ElektorLabs/MultiRF-Dev-Board/hardware/MultiRF_DevBoard/MultiRF_DevBoard.kicad_pcb

## KiCad design hardware/MultiRF_DevBoard/MultiRF_DevBoard.kicad_pcb (2026-07-22)

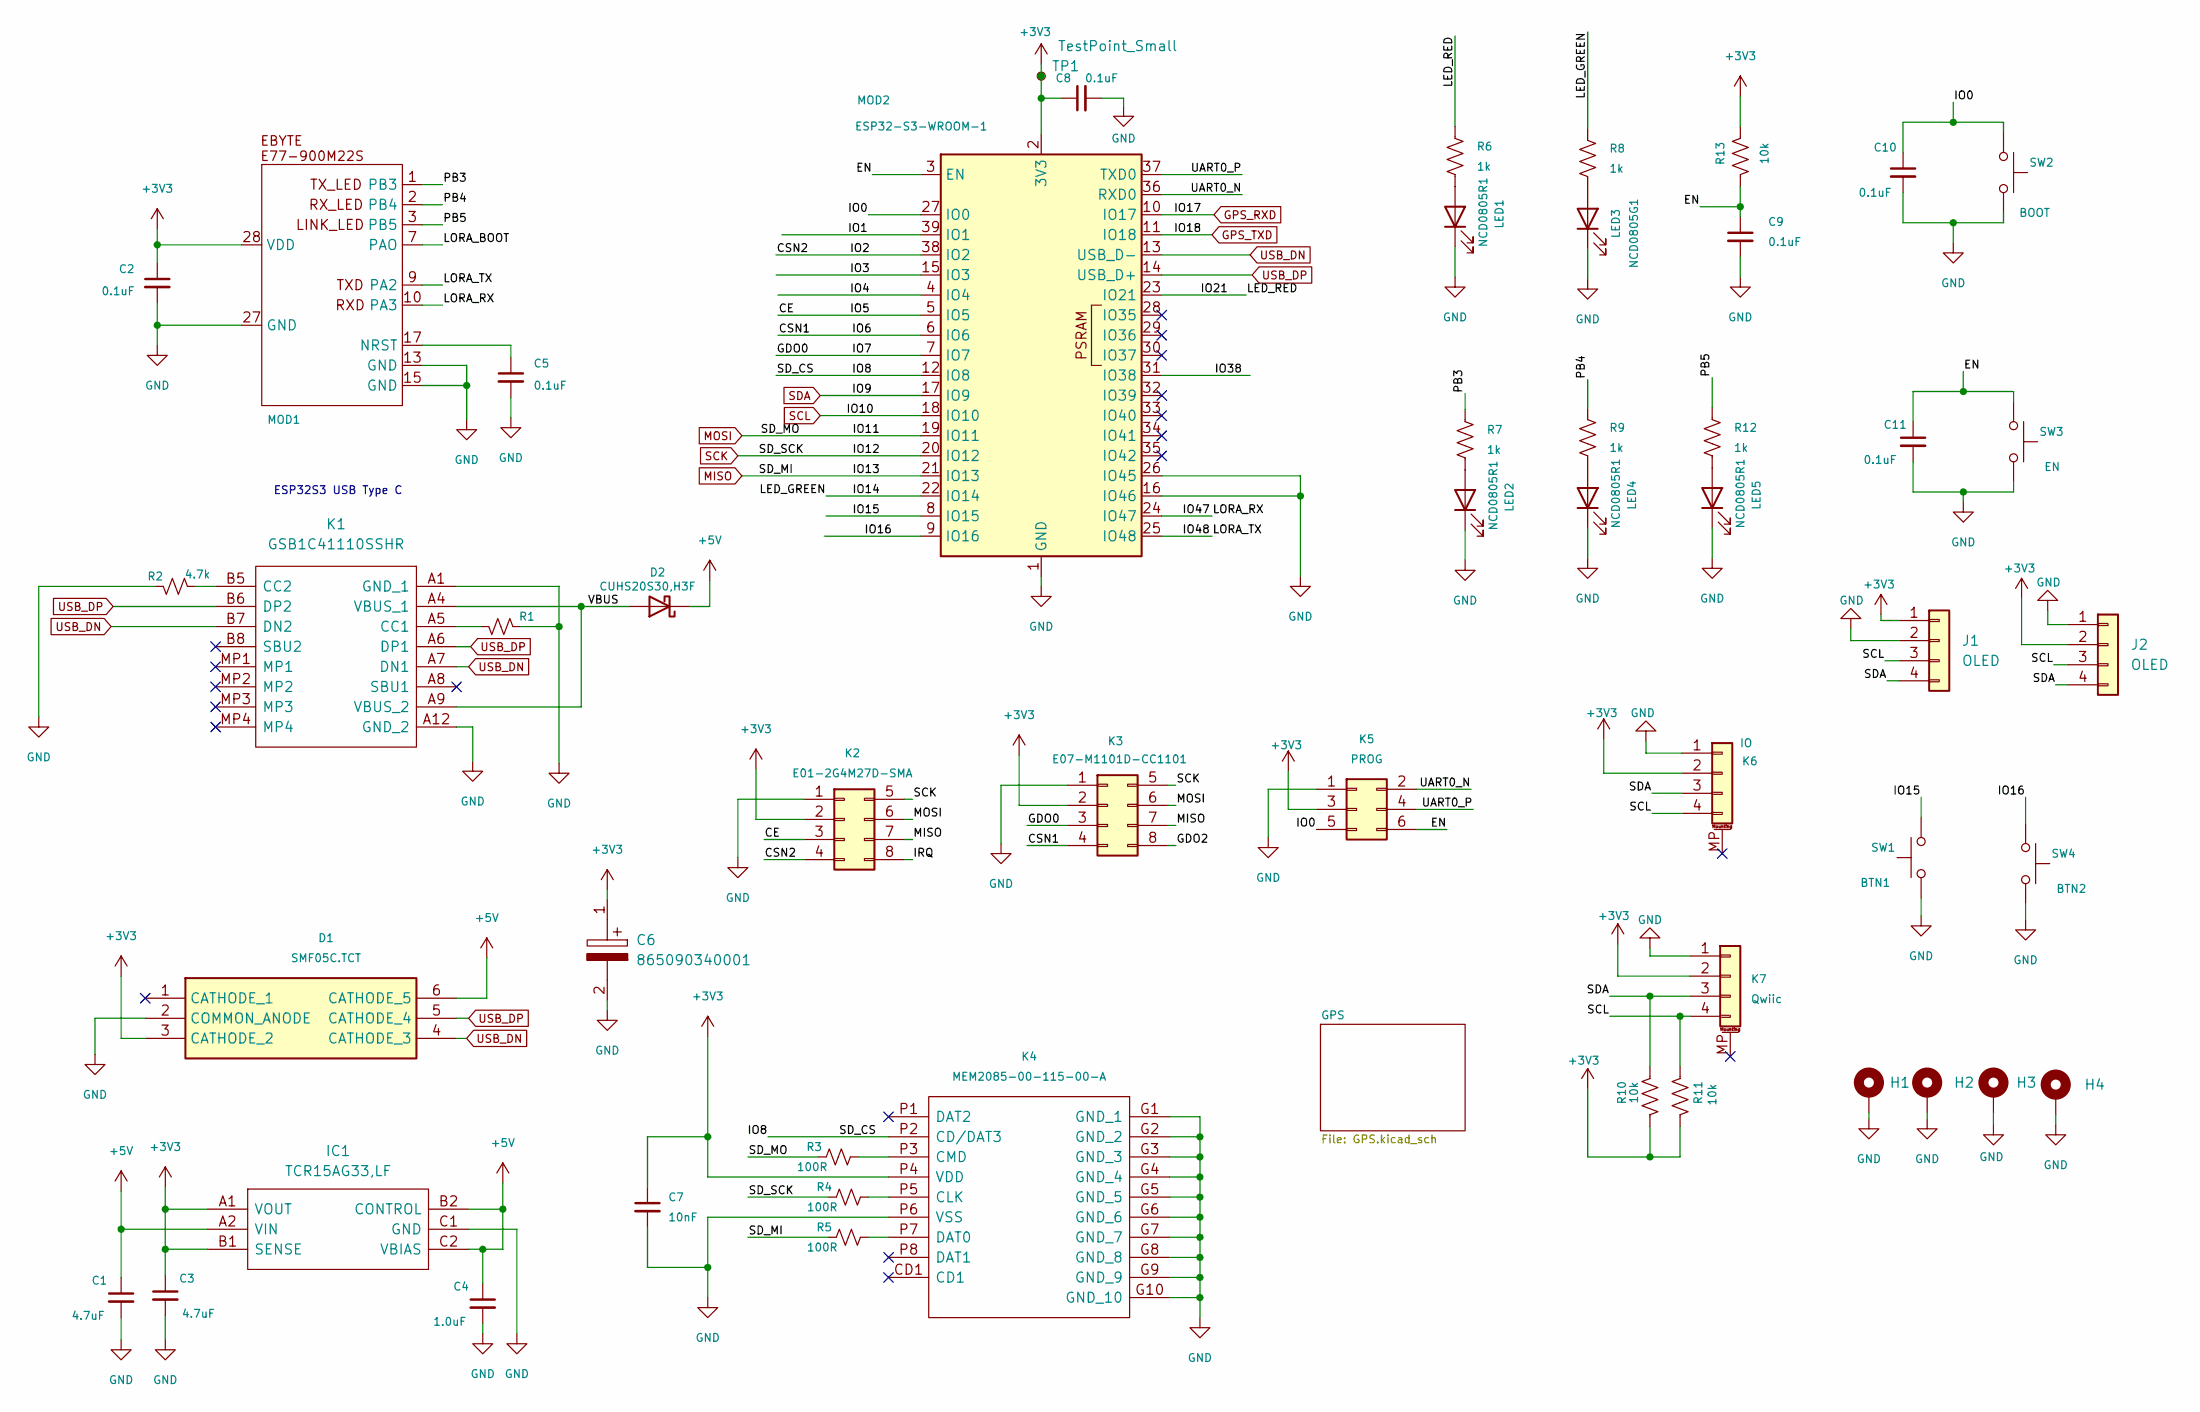
[picture p1: schematic MultiRF_DevBoard.kicad_sch, Wireless Array]

Parts:
C1, C3: 4.7uF; C_0805_2012Metric; Manufacturer_Part_Number C0805C104M5RACTU; Mouser Part Number 80-C0805C104M5R
C2, C5, C10, C11: 0.1uF; C_0805_2012Metric; Manufacturer_Part_Number C0805C104M5RACTU; Mouser Part Number 80-C0805C104M5R
C4: 1.0uF; C_0805_2012Metric; Manufacturer_Part_Number C0805C104M5RACTU; Mouser Part Number 80-C0805C104M5R
C6: 865090340001; CAPAE430X550N; Mouser Part Number 710-865090340001
C7: 10nF; C_0805_2012Metric; Manufacturer_Part_Number C0402C103K5RAC7411; Mouser Part Number 80-C0402C103K5R7411
C8, C9: 0.1uF; C_0805_2012Metric; Manufacturer_Part_Number C1608X7R1H104K080AA; Mouser Part Number 810-C1608X7R1H104K
D1: SMF05C.TCT; SOT65P210X110-6N; Mouser Part Number 947-SMF05C.TCT
D2: CUHS20S30,H3F; CUHS20S40H3F; Mouser Part Number 757-CUHS20S30H3F
H1, H2, H3, H4: MountingHole_Pad; MountingHole_3.2mm_M3_DIN965_Pad
IC1: TCR15AG33,LF; BGA6C40P2X3_80X120X33; Mouser Part Number 757-TCR15AG33LF
J1, J2: OLED; PinHeader_1x04_P2.54mm_Vertical
K1: GSB1C41110SSHR; Manufacturer_Part_Number GSB1C41110SSHR
K2: E01-2G4M27D-SMA; PinHeader_2x04_P2.54mm_Vertical
K3: E07-M1101D-CC1101; PinHeader_2x04_P2.54mm_Vertical
K4: MEM2085-00-115-00-A; MEM20850011500A; Mouser Part Number 640-MEM20850011500A
K5: PROG; PinHeader_2x03_P2.54mm_Vertical; Manufacturer_Part_Number PinHeader_2x03_P2.54mm_Vertical
K6: IO; JST_PH_S4B-PH-SM4-TB_1x04-1MP_P2.00mm_Horizontal; Manufacturer_Part_Number JST_PH_S4B-PH-SM4-TB_1x04-1MP_P2.00mm_H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
K7: Qwiic; JST_SH_SM04B-SRSS-TB_1x04-1MP_P1.00mm_Horizontal; Manufacturer_Part_Number JST_SH_SM04B-SRSS-TB_1x04-1MP_P1.00mm_H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
LED1, LED2, LED4, LED5: NCD0805R1; LED_0805_2012Metric_Pad1.15x1.40mm_HandSolder; Manufacturer_Part_Number NCD0805R1
LED3: NCD0805G1; LED_0805_2012Metric_Pad1.15x1.40mm_HandSolder; Manufacturer_Part_Number NCD0805G1
MOD1: E07-900M10S
MOD2: ESP32-S3-WROOM-1; Manufacturer_Part_Number ESP32-S3-WROOM-1
R1, R2: 4.7k; R_0805_2012Metric; Manufacturer_Part_Number RCS06034K70FKEA; Mouser Part Number 71-RCS06034K70FKEA
R3, R4, R5: 100R; R_0805_2012Metric; Manufacturer_Part_Number MCT0603PD1000DP500; Mouser Part Number 594-MCT0603PD1000DP5
R6, R7, R8, R9, R12: 1k; R_0805_2012Metric; Manufacturer_Part_Number CHP0805-FX-1001ELF; Mouser Part Number 652-CHP0805FX1001ELF
R10, R11, R13: 10k; R_0805_2012Metric; Manufacturer_Part_Number RCS060310K0FKEA; Mouser Part Number 71-RCS060310K0JNEA
SW1: BTN1; SKRKAEE020; Manufacturer_Part_Number SKRKAEE020; Mouser Part Number SKRKAEE020
SW2: BOOT; SKRKAEE020; Manufacturer_Part_Number SKRKAEE020; Mouser Part Number SKRKAEE020
SW3: EN; SKRKAEE020; Manufacturer_Part_Number SKRKAEE020; Mouser Part Number SKRKAEE020
SW4: BTN2; SKRKAEE020; Manufacturer_Part_Number SKRKAEE020; Mouser Part Number SKRKAEE020
TP1: TestPoint_Small

Connections:
+3V3: C2.1, C3.1, C6.1, C7.1, C8.1, D1.3 (CATHODE_2), IC1.A1 (VOUT), IC1.B1 (SENSE), J1.1, J2.2, K2.2, K3.2, K4.P4 (VDD), K5.3, K6.2, K7.2, MOD1.28 (VDD), MOD2.2 (3V3), R10.1, R11.1, R13.2, TP1.1; also elsewhere on the board
+5V: C1.1, C4.1, D1.6 (CATHODE_5), D2.1 (K), IC1.A2 (VIN), IC1.B2 (CONTROL), IC1.C2 (VBIAS)
/CE: K2.3, MOD2.5 (IO5)
/CSN1: K3.4, MOD2.6 (IO6)
/CSN2: K2.4, MOD2.38 (IO2)
/EN: C9.1, C11.1, K5.6, MOD2.3 (EN), R13.1, SW3.1
/GDO0: K3.3, MOD2.7 (IO7)
/GDO2: K3.8
/IO0: C10.1, K5.5, MOD2.27 (IO0), SW2.1
/IO1: MOD2.39 (IO1)
/IO3: MOD2.15 (IO3)
/IO4: MOD2.4 (IO4)
/IO8: K4.P2 (CD/DAT3), MOD2.12 (IO8)
/IO14: MOD2.22 (IO14), R8.2
/IO15: MOD2.8 (IO15), SW1.1
/IO16: MOD2.9 (IO16), SW4.1
/IO21: MOD2.23 (IO21), R6.2
/IO38: MOD2.31 (IO38)
/IO47: MOD1.10 (PA3), MOD2.24 (IO47)
/IO48: MOD1.9 (PA2), MOD2.25 (IO48)
/IRQ: K2.8
/LORA_BOOT: MOD1.7 (PAO)
/PB3: MOD1.1 (PB3), R7.2
/PB4: MOD1.2 (PB4), R9.2
/PB5: MOD1.3 (PB5), R12.2
/UART0_N: K5.2, MOD2.36 (RXD0)
/UART0_P: K5.4, MOD2.37 (TXD0)
/VBUS: D2.2 (A), K1.A4 (VBUS_1), K1.A9 (VBUS_2)
GND: C1.2, C2.2, C3.2, C4.2, C5.2, C6.2, C7.2, C8.2, C9.2, C10.2, C11.2, D1.2 (COMMON_ANODE), H1.1 (1_1), H2.1 (1_1), H3.1 (1_1), H4.1 (1_1), IC1.C1 (GND), J1.2, J2.1, K1.A1 (GND_1), K1.A12 (GND_2), K2.1, K3.1, K4.G1 (GND_1), K4.G2 (GND_2), K4.G3 (GND_3), K4.G4 (GND_4), K4.G5 (GND_5), K4.G6 (GND_6), K4.G7 (GND_7), K4.G8 (GND_8), K4.G9 (GND_9), K4.G10 (GND_10), K4.P6 (VSS), K5.1, K6.1, K7.1, LED1.1 (K), LED2.1 (K), LED3.1 (K), LED4.1 (K), LED5.1 (K), MOD1.13 (GND), MOD1.15 (GND), MOD1.27 (GND), MOD2.1 (GND), MOD2.16 (IO46), MOD2.26 (IO45), MOD2.40 (GND), MOD2.41 (GND), R1.2, R2.1, SW1.2, SW2.2, SW3.2, SW4.2; also elsewhere on the board
GPS_RXD: MOD2.10 (IO17); also elsewhere on the board
GPS_TXD: MOD2.11 (IO18); also elsewhere on the board
MISO: K2.7, K3.7, MOD2.21 (IO13), R5.1
MOSI: K2.6, K3.6, MOD2.19 (IO11), R3.1
unnamed: K1.A5 (CC1), R1.1
unnamed: K1.B5 (CC2), R2.2
unnamed: K4.P5 (CLK), R4.2
unnamed: K4.P3 (CMD), R3.2
unnamed: K4.P7 (DAT0), R5.2
unnamed: LED1.2 (A), R6.1
unnamed: LED2.2 (A), R7.1
unnamed: LED3.2 (A), R8.1
unnamed: LED4.2 (A), R9.1
unnamed: LED5.2 (A), R12.1
unnamed: C5.1, MOD1.17 (NRST)
SCK: K2.5, K3.5, MOD2.20 (IO12), R4.1
SCL: J1.3, J2.3, K6.4, K7.4, MOD2.18 (IO10), R11.2
SDA: J1.4, J2.4, K6.3, K7.3, MOD2.17 (IO9), R10.2
USB_DN: D1.4 (CATHODE_3), K1.A7 (DN1), K1.B7 (DN2), MOD2.13 (USB_D-)
USB_DP: D1.5 (CATHODE_4), K1.A6 (DP1), K1.B6 (DP2), MOD2.14 (USB_D+)

Notes on the sheet:
ESP32S3 USB Type C

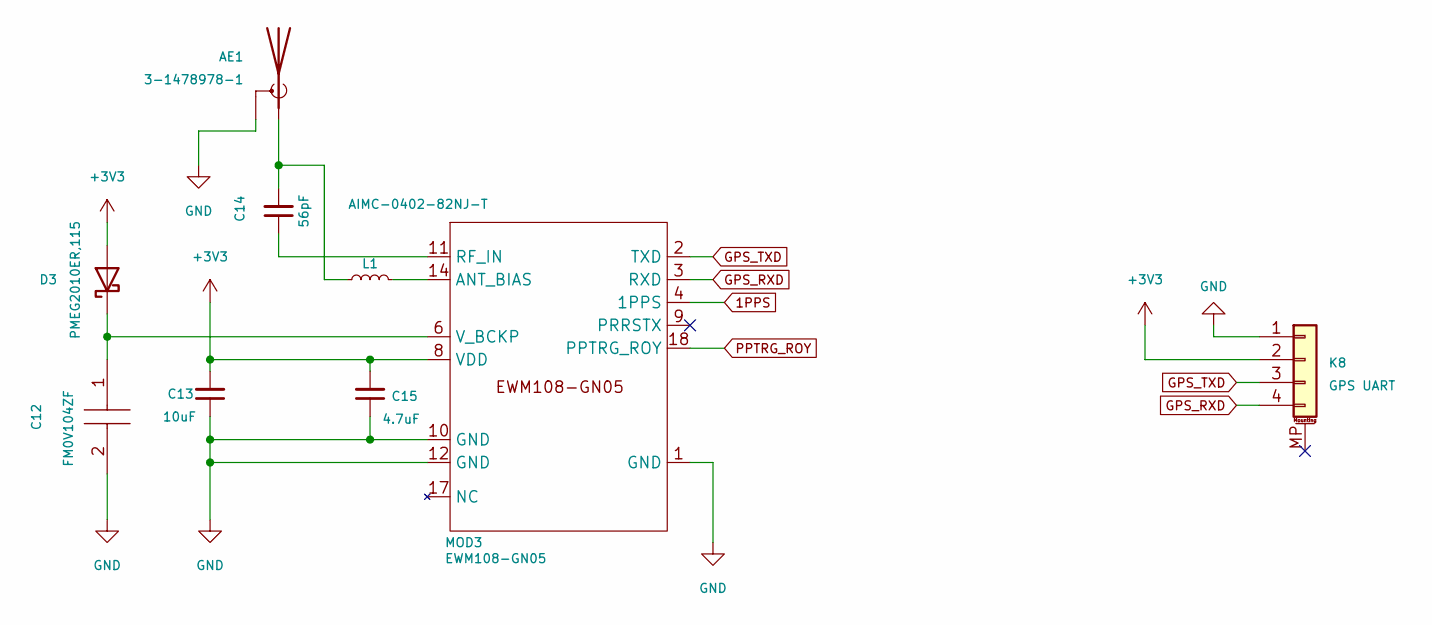
[picture p2: schematic GPS.kicad_sch]

Parts:
AE1: 3-1478978-1; 314789781; Mouser Part Number 571-3-1478978-1
C12: FM0V104ZF; Mouser Part Number 80-FM0V104ZF
C13: 10uF; C_0805_2012Metric; Mouser Part Number 81-GRM155R60J475ME7D
C14: 56pF; C_0603_1608Metric_Pad1.08x0.95mm_HandSolder; Manufacturer_Part_Number 600S560KT250T; Mouser Part Number 581-600S560KT250T
C15: 4.7uF; C_0805_2012Metric; Mouser Part Number 81-GRM155R60J475ME7D
D3: PMEG2010ER,115; PMEG2010ER115; Mouser Part Number 771-PMEG2010ER115
K8: GPS UART; JST_PH_S4B-PH-SM4-TB_1x04-1MP_P2.00mm_Horizontal; Manufacturer_Part_Number Connector_JST:JST_PH_S4B-PH-SM4-TB_1x04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
L1: AIMC-0402-82NJ-T; INDC1005X65N; Manufacturer_Part_Number AIMC-0402-82NJ-T
MOD3: EWM108-GN05; PCBComponent_1; Manufacturer_Part_Number EWM108-GN05

Connections:
1PPS: MOD3.4 (1PPS)
+3V3: C13.2, C15.2, D3.2 (A), K8.2, MOD3.8 (VDD); also elsewhere on the board
GND: AE1.1 (eShield), AE1.2 (Shield), AE1.3 (Shield), AE1.4 (Shield), C12.2, C13.1, C15.1, K8.1, MOD3.1 (GND), MOD3.10 (GND), MOD3.12 (GND); also elsewhere on the board
GPS_RXD: K8.4, MOD3.3 (RXD); also elsewhere on the board
GPS_TXD: K8.3, MOD3.2 (TXD); also elsewhere on the board
unnamed: AE1.5 (A), C14.2, L1.1
unnamed: C12.1, D3.1 (K), MOD3.6 (V_BCKP)
unnamed: L1.2, MOD3.14 (ANT_BIAS)
unnamed: C14.1, MOD3.11 (RF_IN)
PPTRG_ROY: MOD3.18 (PPTRG_ROY)

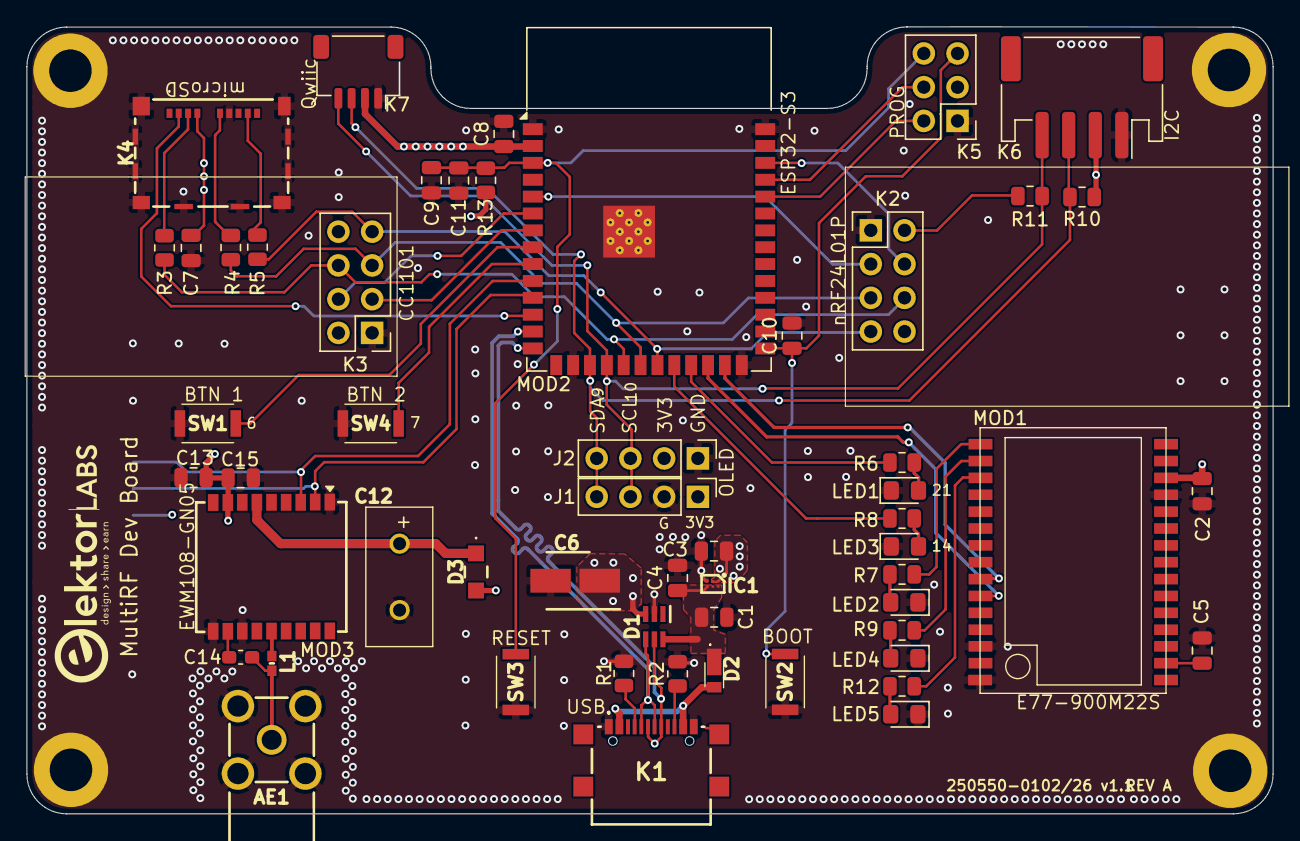
[picture p3: board MultiRF_DevBoard.kicad_pcb from above]

Board: 4 copper layers, 93.8 x 59.3 mm, 60 parts (1 on the bottom side), 46 nets.
