ElektorLabs/MultiRF-Dev-Board/(commit log)

2026-07-22 added demos
    CC1101 Demo built on the Arduino IDE.
2026-07-22 added hardware files
    KiCAD hardware files for the MultiRF Dev Board.
    [GPS.kicad_sch, MultiRF_DevBoard.kicad_pcb, MultiRF_DevBoard.kicad_sch]
2026-07-22 Refactor CC1101 demos to non-blocking I/O + add CC1101-Extended lib
    Major refactoring of all demo sketches to use non-blocking, interrupt-driven patterns with millis()-based timing instead of delay().
    Key changes:
    - All demos now use readPacket() (non-blocking) instead of receive()
    - Interrupt-driven RX with GDO0 callbacks via receiveCallback()
    - millis() timers replace delay() for TX intervals
    - Channel-based configuration macros (CHANNEL, BASE_FREQ, TX_INTERVAL)
    - Updated method names: getRSSI() → lastRSSI(), getLQI() → lastLQI()
    - Improved serial output formatting and documentation
    New CC1101-Extended library adds:
    - readPacket(): non-blocking packet read with STATUS_TIMEOUT
    - XTEA-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
    [Gateway.ino, Receiver.ino, Relay.ino, Scanner.ino, Sensor.ino, Transmitter.ino]
